ivanantok/weather-station/(list of files, drawings)

Other design files:
Project.pdsprj
